DongjuLee0528/wildfire-spot/models/wildfire_baseline/BoxF1_curve.png

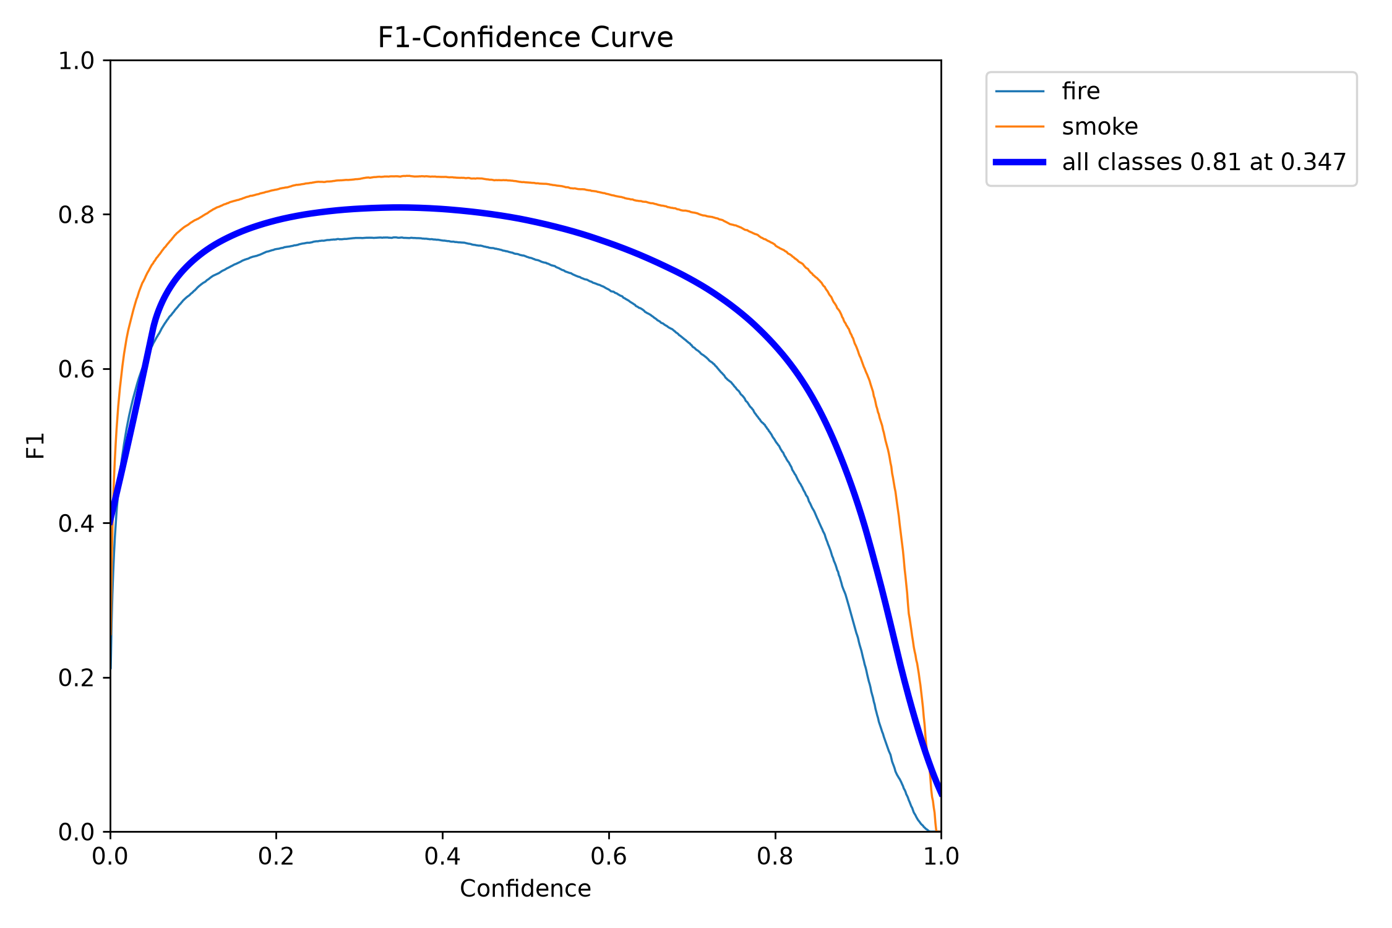
models/wildfire_baseline/BoxF1_curve.png
