DongjuLee0528/wildfire-spot/models/wildfire_baseline/BoxP_curve.png

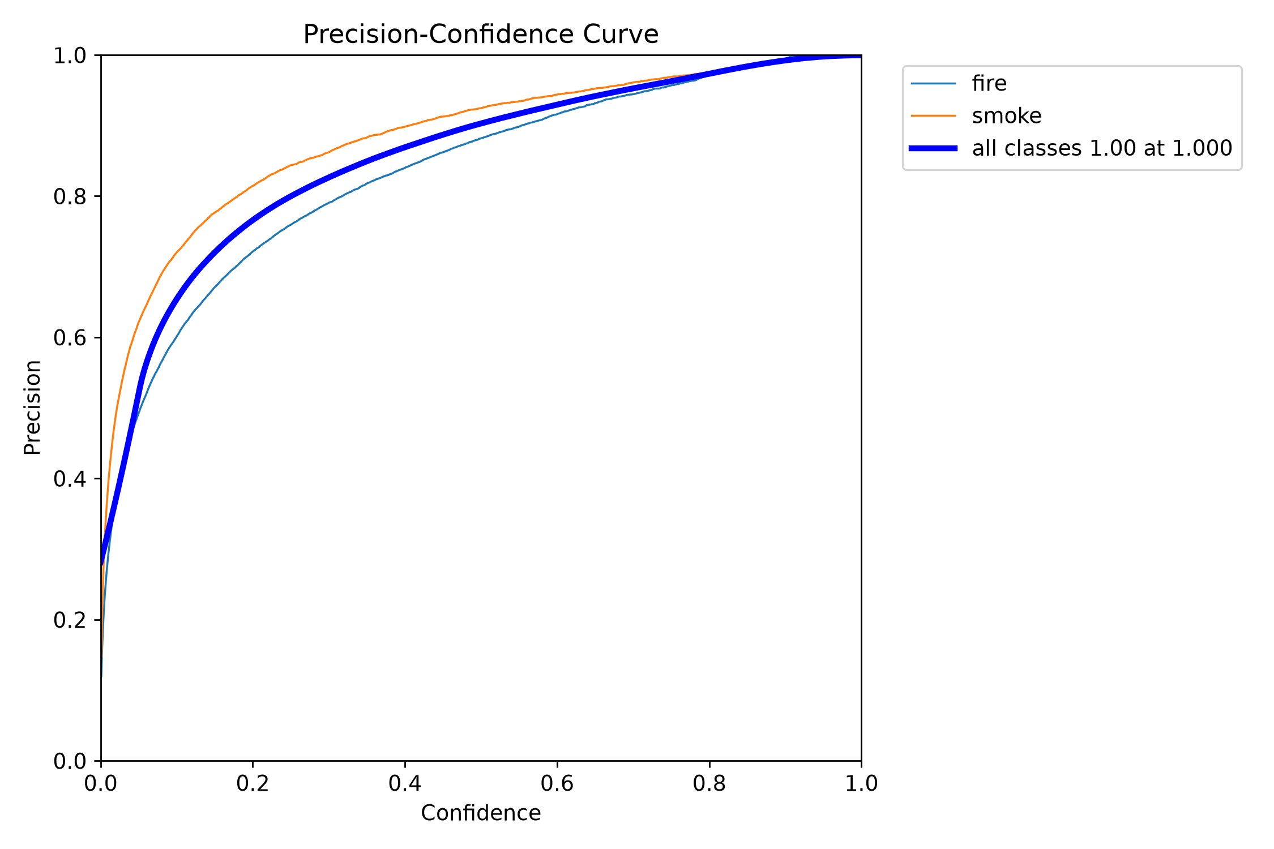
models/wildfire_baseline/BoxP_curve.png
