DongjuLee0528/wildfire-spot/models/wildfire_baseline/BoxPR_curve.png

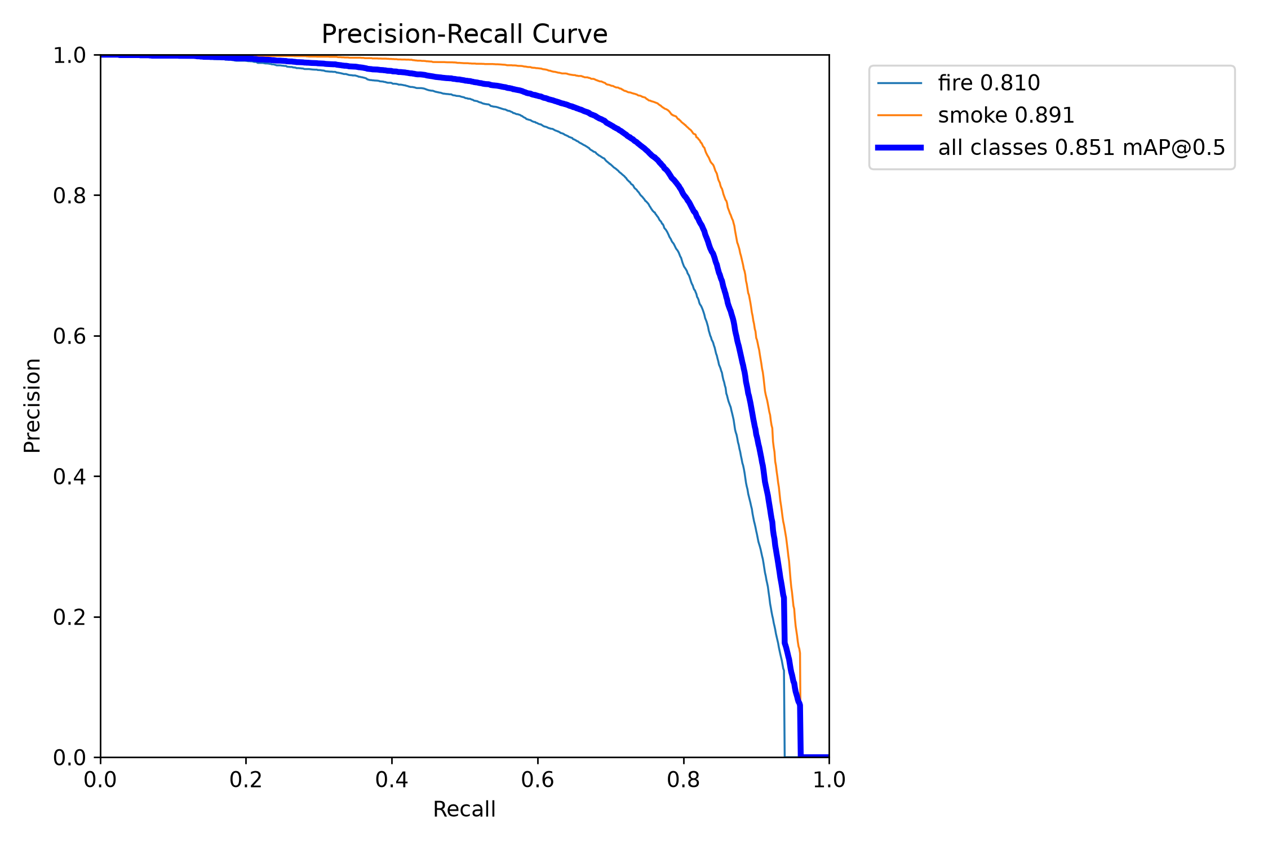
models/wildfire_baseline/BoxPR_curve.png
