DongjuLee0528/wildfire-spot/models/wildfire_baseline/BoxR_curve.png

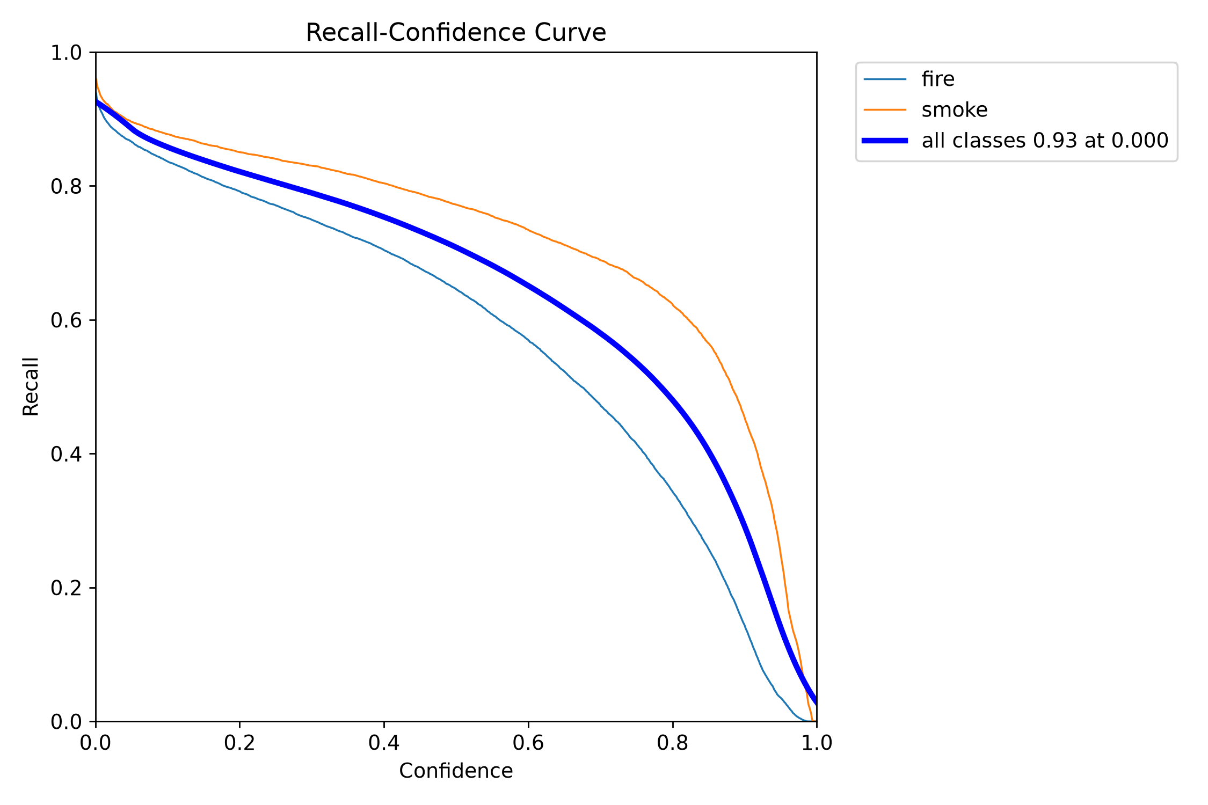
models/wildfire_baseline/BoxR_curve.png
