DongjuLee0528/wildfire-spot/models/wildfire_baseline/confusion_matrix.png

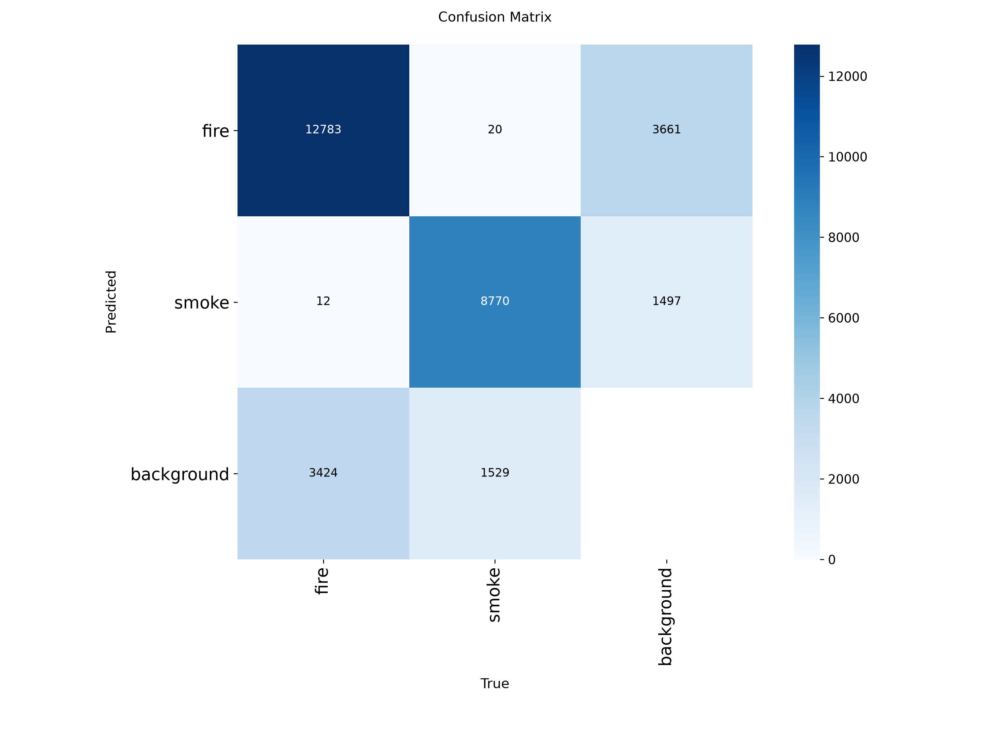
models/wildfire_baseline/confusion_matrix.png
