DongjuLee0528/wildfire-spot/models/wildfire_baseline/confusion_matrix_normalized.png

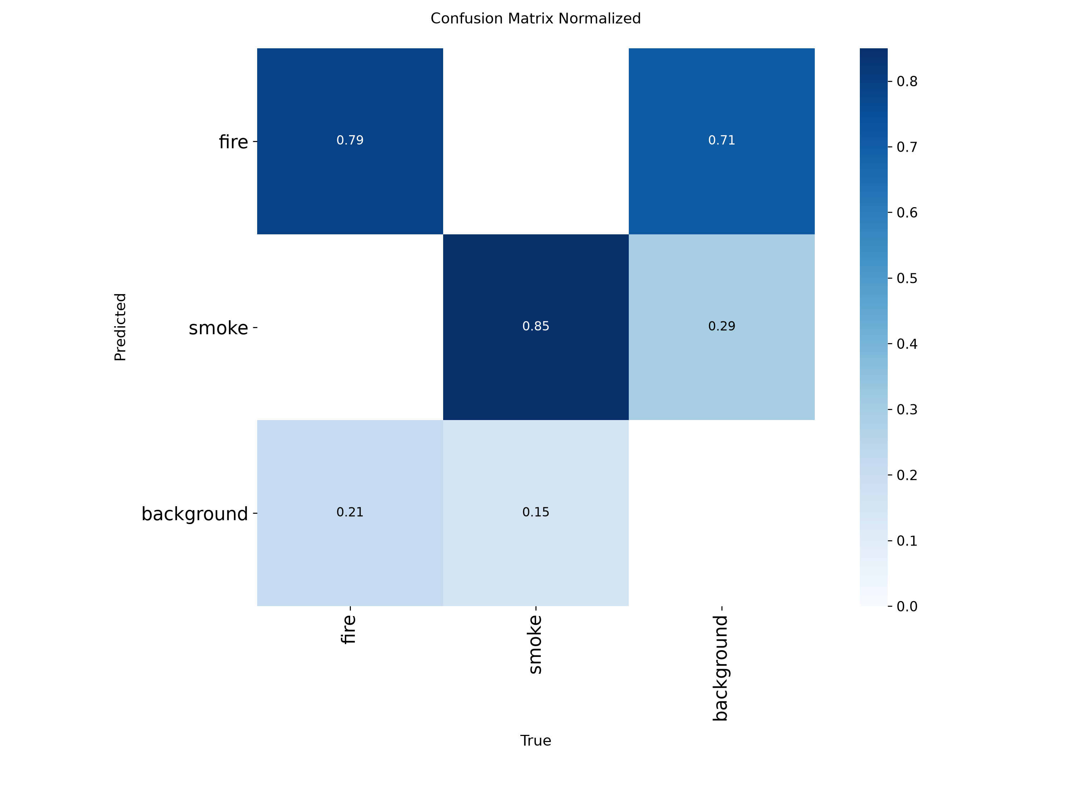
models/wildfire_baseline/confusion_matrix_normalized.png
