DongjuLee0528/wildfire-spot/hardware_cad/stl/R_arm_x2.stl

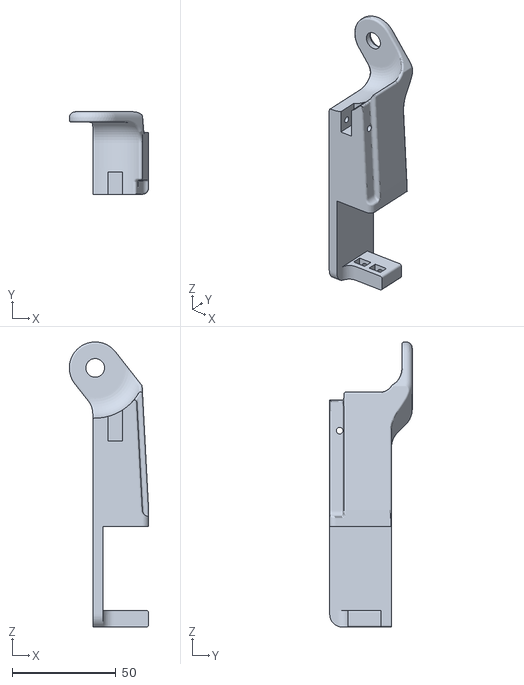
[picture p7: CAD file, 2026-06-15]
hardware_cad/stl/R_arm_x2.stl
38.2 x 39.8 x 137.4
