DongjuLee0528/wildfire-spot/hardware_cad/stltest/lidar_arm.lidar_arm01.stl

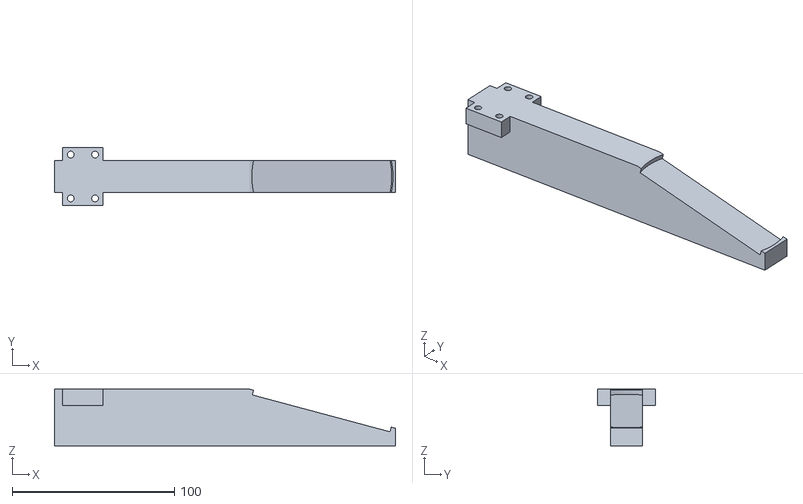
[picture p8: CAD file, 2026-06-16]
hardware_cad/stltest/lidar_arm.lidar_arm01.stl
210.0 x 36.0 x 35.0
