DongjuLee0528/wildfire-spot/hardware_cad/stl/R_wrist_x2.stl

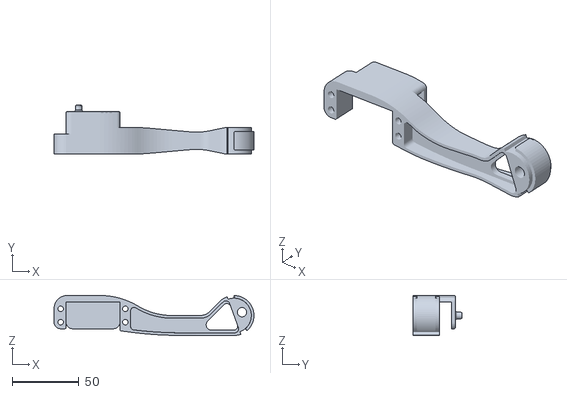
[picture p9: CAD file, 2026-06-15]
hardware_cad/stl/R_wrist_x2.stl
150.0 x 36.9 x 30.0
