DongjuLee0528/wildfire-spot/hardware_cad/stltest/side_cover.stl

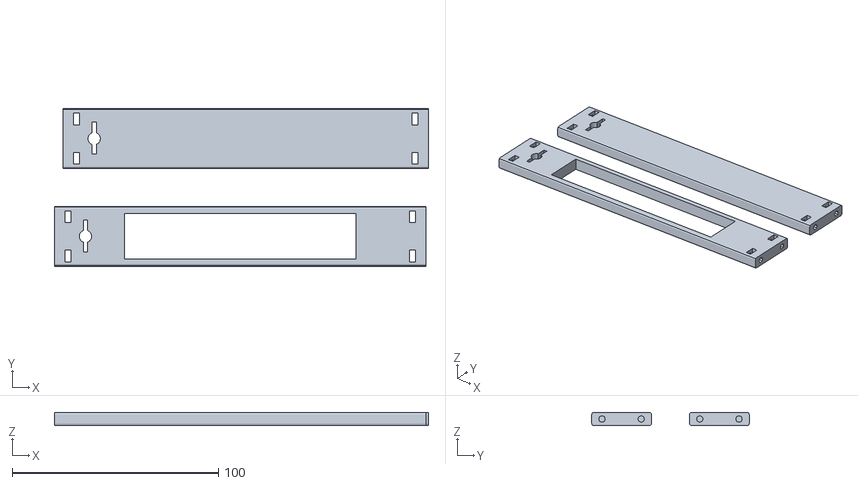
[picture p10: CAD file, 2026-06-16]
hardware_cad/stltest/side_cover.stl
181.2 x 76.4 x 6.50
