DongjuLee0528/wildfire-spot/hardware_cad/stl/R_shoulder.stl

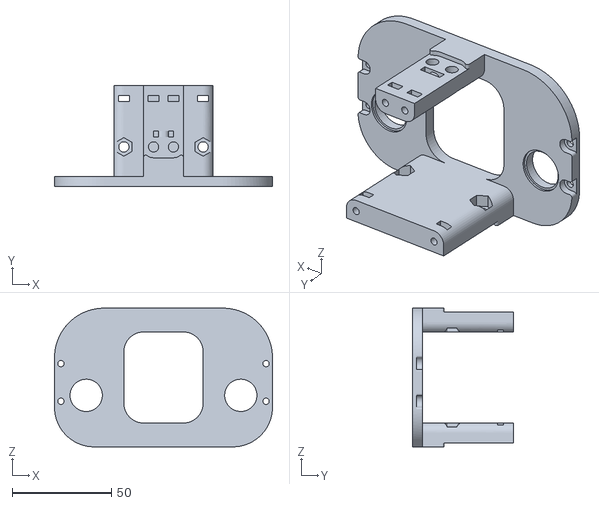
[picture p11: CAD file, 2026-06-15]
hardware_cad/stl/R_shoulder.stl
110.0 x 51.0 x 70.0
