DongjuLee0528/wildfire-spot/hardware_cad/stltest/lidar_arm.lidar_arm02.stl

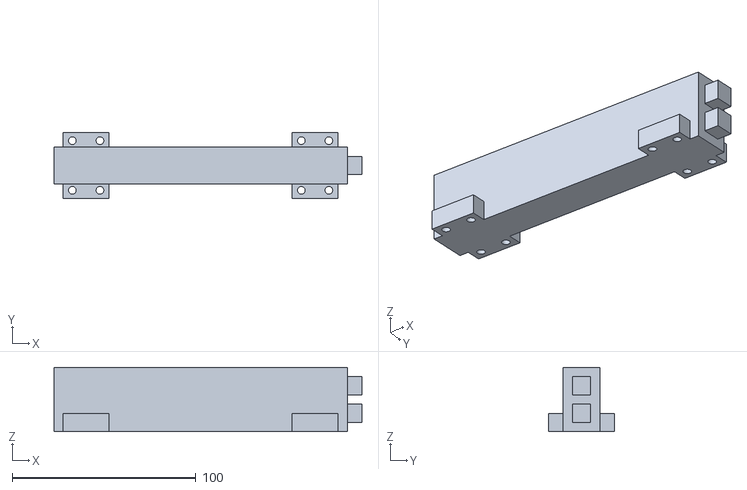
[picture p12: CAD file, 2026-06-16]
hardware_cad/stltest/lidar_arm.lidar_arm02.stl
167.5 x 36.0 x 35.0
