DongjuLee0528/wildfire-spot/hardware_cad/stl/R_side_plate.stl

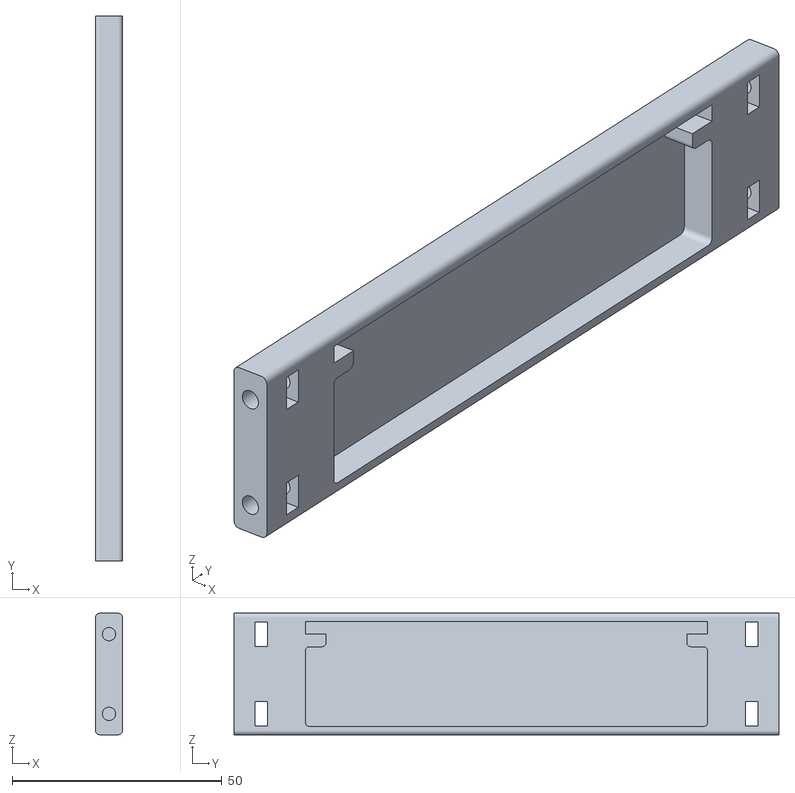
[picture p13: CAD file, 2026-06-15]
hardware_cad/stl/R_side_plate.stl
6.50 x 130.0 x 29.0
