DongjuLee0528/wildfire-spot/hardware_cad/stltest/Front_Cover.stl

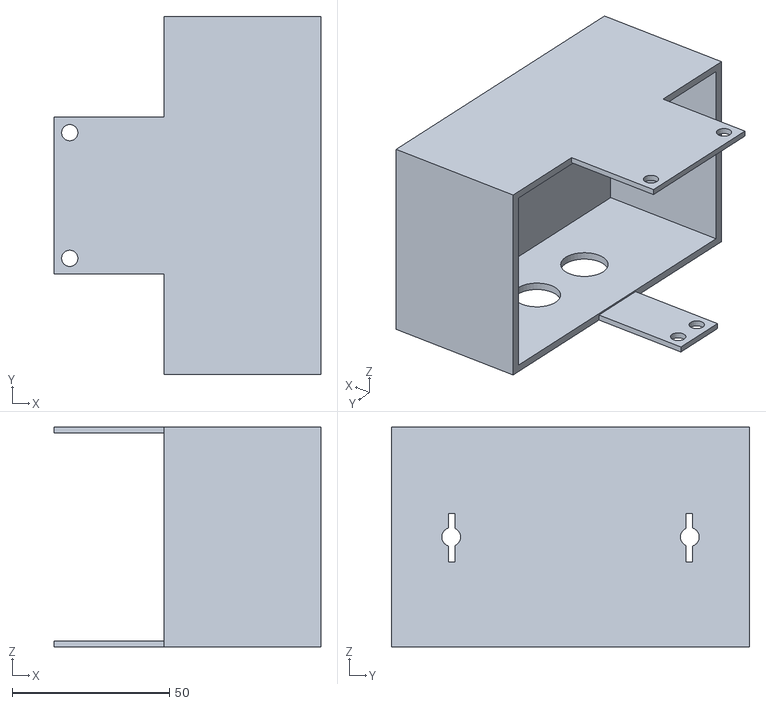
[picture p14: CAD file, 2026-06-16]
hardware_cad/stltest/Front_Cover.stl
85.0 x 114.0 x 70.0
