DongjuLee0528/wildfire-spot/hardware_cad/stl/top_cover.stl

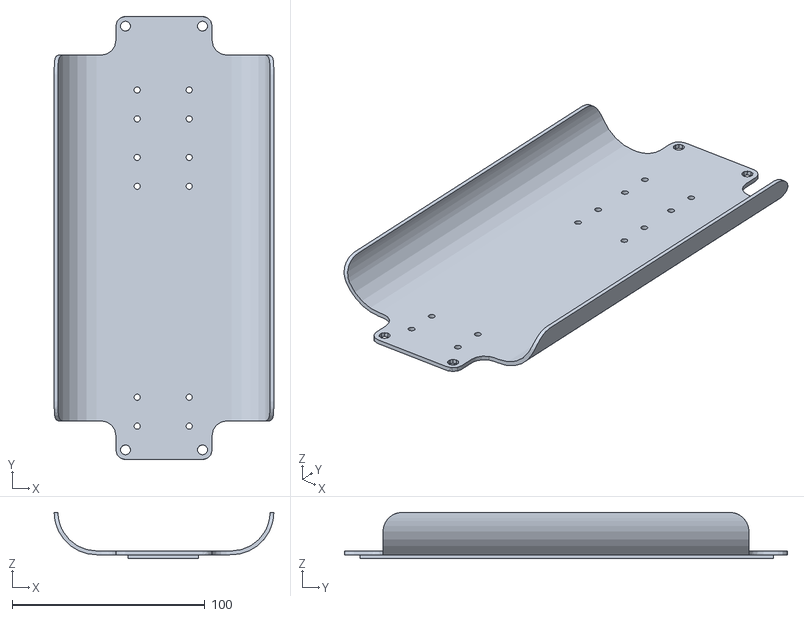
[picture p15: CAD file, 2026-06-15]
hardware_cad/stl/top_cover.stl
114.0 x 230.0 x 24.0
