DongjuLee0528/wildfire-spot/hardware_cad/stl/R_arm_cover_x2.stl

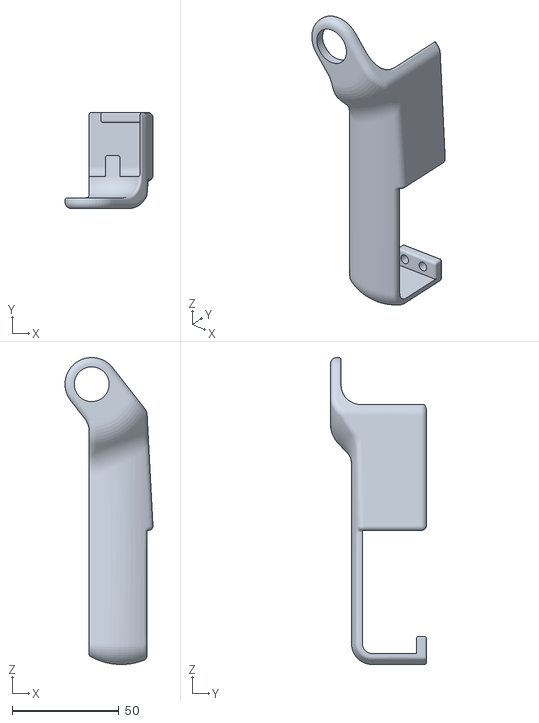
[picture p16: CAD file, 2026-06-14]
hardware_cad/stl/R_arm_cover_x2.stl
41.2 x 45.0 x 143.5
