DongjuLee0528/wildfire-spot/hardware_cad/stl/lidar_plate.lidar_plate.stl

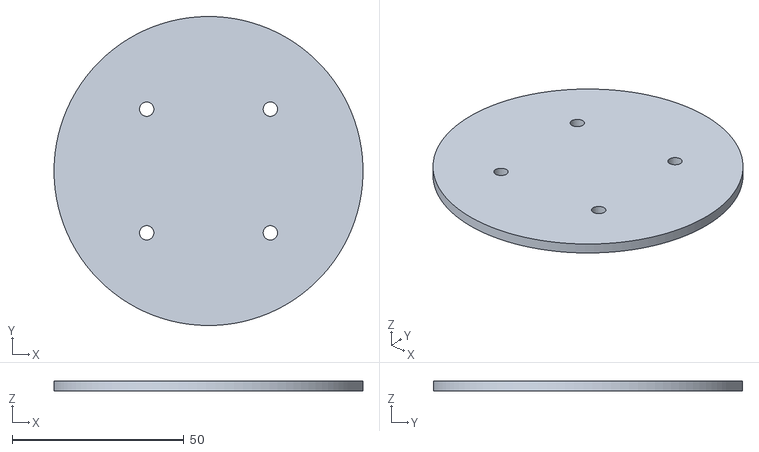
[picture p17: CAD file, 2026-06-14]
hardware_cad/stl/lidar_plate.lidar_plate.stl
90.0 x 90.0 x 3.00
