DongjuLee0528/wildfire-spot/hardware_cad/stl/L_side_plate.stl

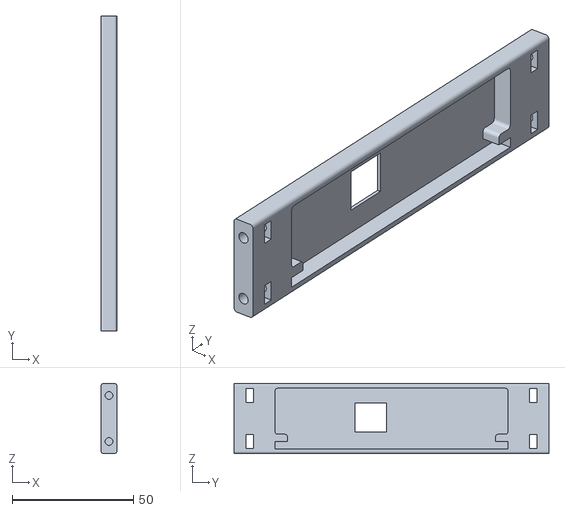
[picture p18: CAD file, 2026-06-14]
hardware_cad/stl/L_side_plate.stl
6.50 x 130.0 x 29.0
