DongjuLee0528/wildfire-spot/hardware_cad/stl/R_arm_joint_x2.stl

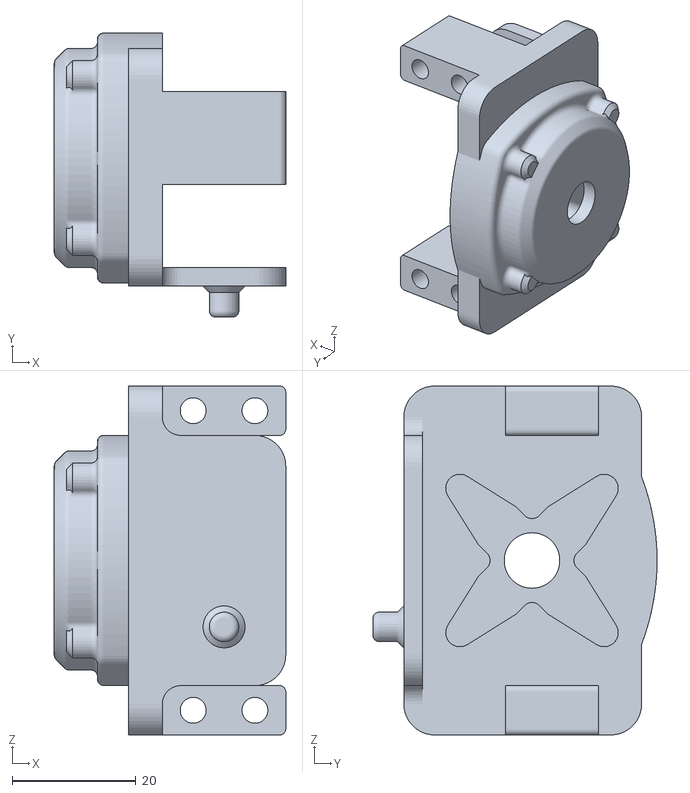
[picture p19: CAD file, 2026-06-14]
hardware_cad/stl/R_arm_joint_x2.stl
37.5 x 46.0 x 56.5
