DongjuLee0528/wildfire-spot/hardware_cad/stl/mg995_servo_holder.stl

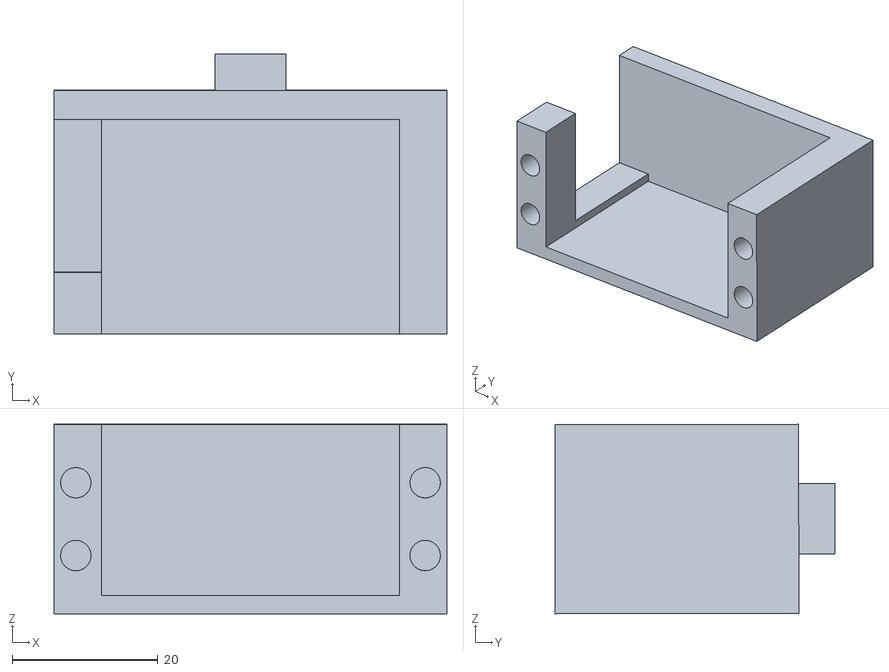
[picture p20: CAD file, 2026-06-14]
hardware_cad/stl/mg995_servo_holder.stl
54.0 x 38.5 x 26.0
