DongjuLee0528/wildfire-spot/hardware_cad/stl/lidar_arm.lidar_arm.stl

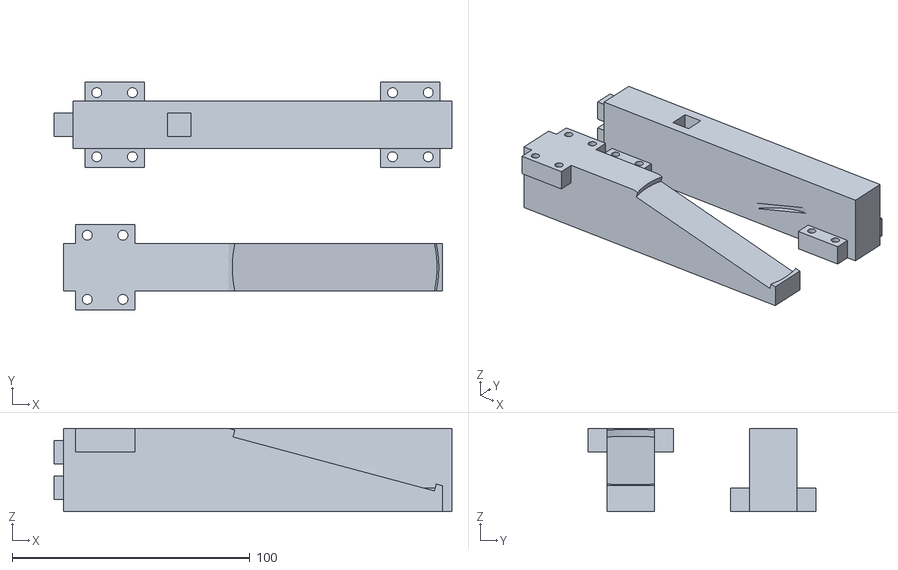
[picture p21: CAD file, 2026-06-14]
hardware_cad/stl/lidar_arm.lidar_arm.stl
167.5 x 96.0 x 35.0
