DongjuLee0528/wildfire-spot/hardware_cad/stl/F_shoulder.stl

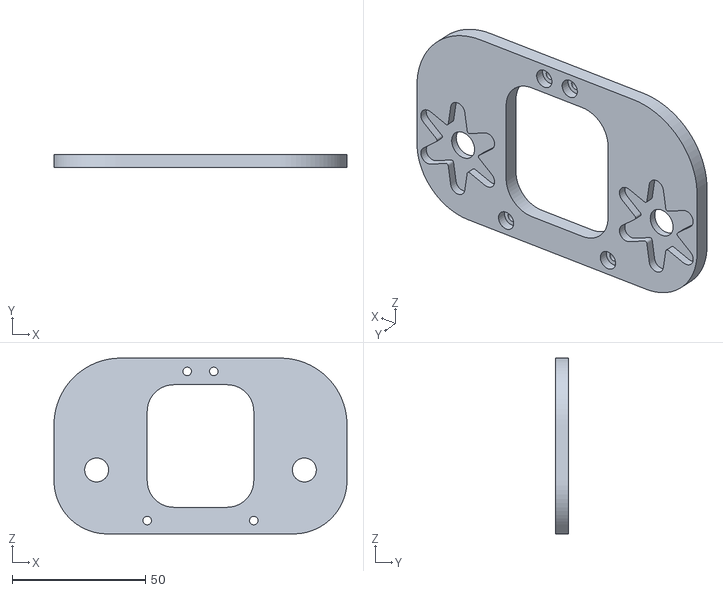
[picture p22: CAD file, 2026-06-13]
hardware_cad/stl/F_shoulder.stl
110.0 x 5.00 x 66.0
