DongjuLee0528/wildfire-spot/hardware_cad/stl/bottom_cover.stl

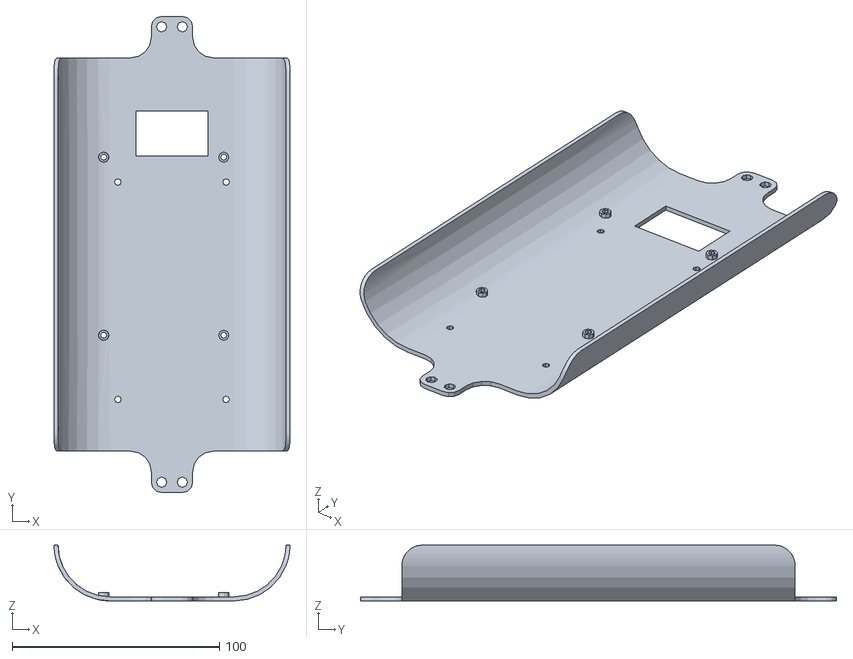
[picture p23: CAD file, 2026-06-13]
hardware_cad/stl/bottom_cover.stl
114.0 x 230.0 x 27.0
