DongjuLee0528/wildfire-spot/hardware_cad/stl/battery_cover.battery_cover.stl

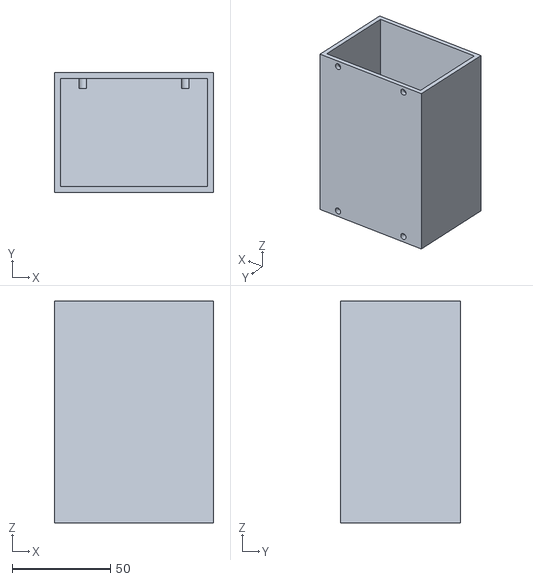
[picture p24: CAD file, 2026-06-13]
hardware_cad/stl/battery_cover.battery_cover.stl
81.0 x 61.0 x 113.0
