DongjuLee0528/wildfire-spot/(list of files, cad)

Other CAD files:
hardware_cad/stl/L_wrist_x2.stl
hardware_cad/stl/L_arm_cover_x2.stl
hardware_cad/stl/L_arm_joint_x2.stl
hardware_cad/stl/L_arm_x2.stl
