DongjuLee0528/wildfire-spot/models/wildfire_baseline/results.csv

epoch | time | train/box_loss | train/cls_loss | train/dfl_loss | metrics/precision(B) | metrics/recall(B) | metrics/mAP50(B) | metrics/mAP50-95(B) | val/box_loss | val/cls_loss | val/dfl_loss | lr/pg0 | lr/pg1 | lr/pg2 | lr/pg3 | lr/pg4 | lr/pg5 | lr/pg6 | lr/pg7
1 | 4322.97 | 1.55921 | 2.16494 | 1.56906 | 0.68608 | 0.61561 | 0.67741 | 0.35 | 1.6771 | 1.45263 | 1.60846 | 0.0099988 | 0.00333293 | 0.0099988 | 0.00333293 | 0.0099988 | 0.00333293 | 0.0099988 | 0.00333293
2 | 9353.63 | 1.54447 | 1.658 | 1.56434 | 0.7005 | 0.63101 | 0.69673 | 0.37994 | 1.57246 | 1.4124 | 1.55244 | 0.0198998 | 0.00663327 | 0.0198998 | 0.00663327 | 0.0198998 | 0.00663327 | 0.0198998 | 0.00663327
3 | 12533.6 | 1.54933 | 1.64297 | 1.57384 | 0.70442 | 0.63061 | 0.70209 | 0.39707 | 1.52544 | 1.3829 | 1.53039 | 0.0297018 | 0.0099006 | 0.0297018 | 0.0099006 | 0.0297018 | 0.0099006 | 0.0297018 | 0.0099006
4 | 15646 | 1.51858 | 1.55495 | 1.55165 | 0.73068 | 0.64287 | 0.72441 | 0.41471 | 1.49531 | 1.3273 | 1.50934 | 0.0295545 | 0.0098515 | 0.0295545 | 0.0098515 | 0.0295545 | 0.0098515 | 0.0295545 | 0.0098515
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
