DongjuLee0528/wildfire-spot/models/wildfire_baseline/results.png

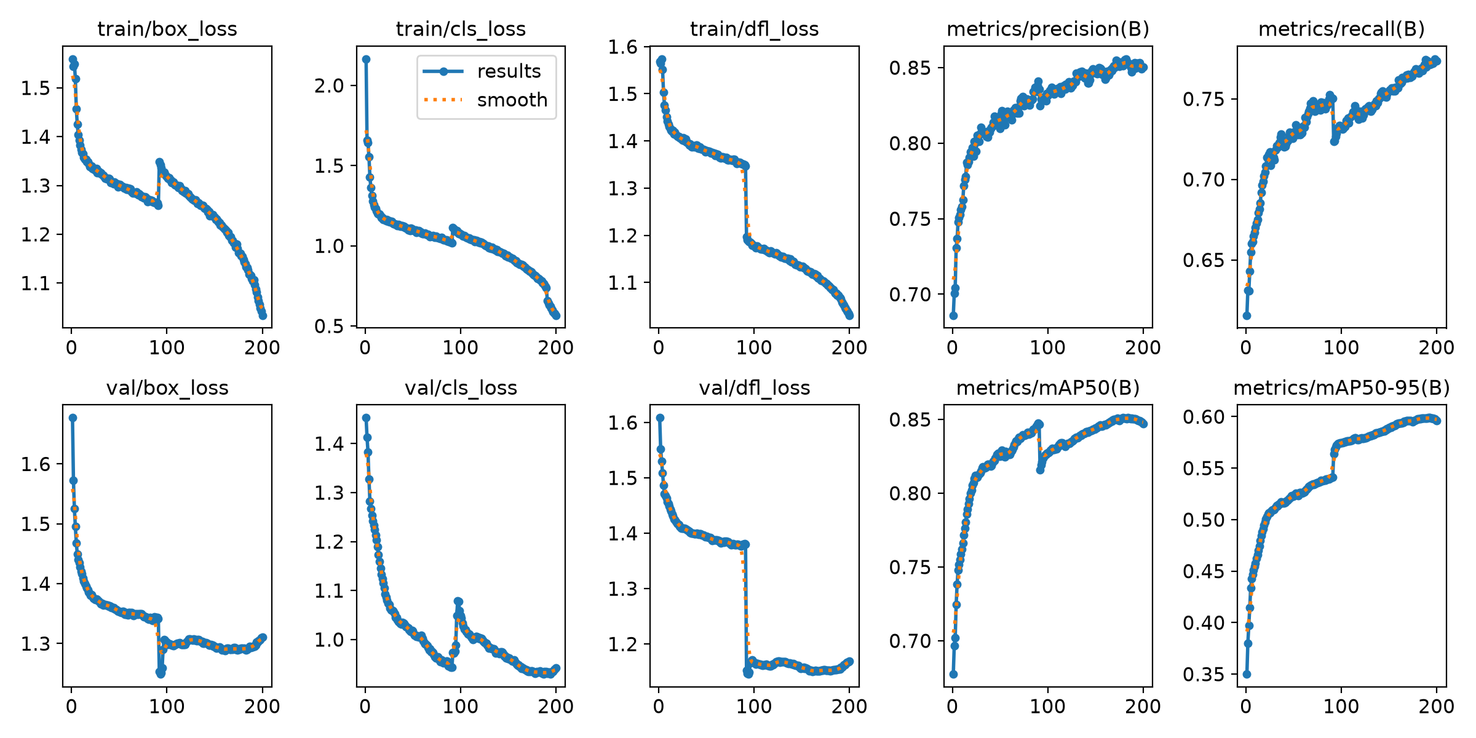
models/wildfire_baseline/results.png
