DongjuLee0528/wildfire-spot/hardware/sensor_manager.py

"""
Sensor management module for wildfire detection.

Integrates multiple sensor types:
- DHT11 temperature and humidity sensor
- KY-026 flame detection sensors
- HC-SR04 ultrasonic distance sensor
"""

from utils.config import (I2C_SCL, I2C_SDA, DHT11_DATA_PIN,
                         KY026_FRONT_LEFT_PIN, KY026_FRONT_RIGHT_PIN, KY026_LEFT_PIN, KY026_RIGHT_PIN,
                         HCSR04_TRIGGER_PIN, HCSR04_ECHO_PIN, ULTRASONIC_DISTANCE_MULTIPLIER,
                         SENSOR_READ_TIMEOUT)
from utils.logger import WildfireLogger

import time

try:
    import adafruit_dht
except ImportError:
    adafruit_dht = None

try:
    import board
except ImportError:
    board = None

try:
    import Jetson.GPIO as GPIO
except ImportError:
    GPIO = None

try:
    import busio
except ImportError:
    busio = None

class FlameReadings(dict):
    """
    Dict subclass for KY-026 flame sensor readings.

    Keyed by position string ('front_left', 'front_right', 'left', 'right').
    Iterating yields values (not keys) so it behaves like a list of booleans
    when consumed by FireDetector._flame_values().
    Integer indexing by position is also supported for legacy callers.
    """

    def __iter__(self):
        """Iterate over values (True/False/None per sensor) instead of keys."""
        return iter(self.values())

    def __bool__(self):
        """Return True if any sensor reports flame detected."""
        return any(self.values())

    def __getitem__(self, key):
        """Support both string key ('front_left') and integer index (0-3)."""
        if isinstance(key, int):
            return list(self.values())[key]
        return super().__getitem__(key)


class SensorManager:
    """
    Manages all environmental sensors for fire detection.

    Handles initialization, reading, and error recovery for:
    - Temperature/humidity monitoring (DHT11)
    - Flame detection (KY-026 IR sensors)
    - Obstacle distance measurement (HC-SR04)
    """
    def __init__(self):
        """
        Initialize all sensors with graceful degradation.

        If individual sensors fail to initialize, the system continues
        operation with available sensors. Failures are logged for debugging.
        """
        self._i2c = None
        self._dht11_available = False
        self._gpio_available = False
        self._last_dht11_reading = None
        self.logger = WildfireLogger("SensorManager")

        if busio is None:
            self.logger.log_error("SensorManager.I2C_init", "busio module is not available")
        else:
            try:
                self._i2c = busio.I2C(I2C_SCL, I2C_SDA)
            except (ValueError, RuntimeError, OSError) as e:
                self.logger.log_error("SensorManager.I2C_init", str(e))

        if adafruit_dht is None:
            self.logger.log_error("SensorManager.DHT11_init", "adafruit_dht module is not available")
        elif board is None:
            self.logger.log_error("SensorManager.DHT11_init", "board module is not available")
        else:
            try:
                self._dht11 = adafruit_dht.DHT11(self._get_dht11_board_pin(DHT11_DATA_PIN))
                self._dht11_available = True
            except (ValueError, RuntimeError, OSError, AttributeError) as e:
                self.logger.log_error("SensorManager.DHT11_init", str(e))

        if GPIO is None:
            self.logger.log_error("SensorManager.GPIO_setmode", "Jetson.GPIO module is not available")
        else:
            try:
                GPIO.setmode(GPIO.BOARD)
                self._gpio_available = True
            except (ValueError, RuntimeError, AttributeError) as e:
                self.logger.log_error("SensorManager.GPIO_setmode", str(e))

        self._ky026_pins = {
            "front_left": KY026_FRONT_LEFT_PIN,
            "front_right": KY026_FRONT_RIGHT_PIN,
            "left": KY026_LEFT_PIN,
            "right": KY026_RIGHT_PIN,
        }
        for pin in self._ky026_pins.values():
            if self._gpio_available and pin is not None:
                try:
                    GPIO.setup(pin, GPIO.IN)
                except (ValueError, RuntimeError, AttributeError) as e:
                    self.logger.log_error("SensorManager.GPIO_setup_KY026", str(e))

        if self._gpio_available and HCSR04_TRIGGER_PIN is not None and HCSR04_ECHO_PIN is not None:
            try:
                GPIO.setup(HCSR04_TRIGGER_PIN, GPIO.OUT)
                GPIO.setup(HCSR04_ECHO_PIN, GPIO.IN)
            except (ValueError, RuntimeError, AttributeError) as e:
                self.logger.log_error("SensorManager.GPIO_setup_HCSR04", str(e))

    def _get_dht11_board_pin(self, pin):
        """
        Translate a BOARD pin number into the corresponding adafruit board attribute.

        Args:
            pin: Integer BOARD pin number (e.g. 18).

        Returns:
            board.Dxx attribute object for use with adafruit_dht.

        Raises:
            ValueError: if the pin number is not in the supported mapping.
            AttributeError: if the board module lacks the expected attribute.
        """
        supported_pins = {
            18: "D18",
        }
        pin_name = supported_pins.get(pin)
        if pin_name is None:
            raise ValueError(f"Unsupported DHT11 BOARD pin: {pin}")
        try:
            return getattr(board, pin_name)
        except AttributeError as e:
            raise AttributeError(f"board.{pin_name} is not available") from e

    def read_dht11(self):
        """
        Read temperature and humidity from DHT11 sensor.

        Retries up to 3 times with 1-second delays because DHT11 frequently
        returns checksum errors on the first read after a period of inactivity.
        Falls back to the last successful reading (_last_dht11_reading) so
        callers always receive a value even during transient sensor errors.

        Returns:
            Tuple of (temperature in Celsius, relative humidity percentage)
            Returns the previous valid reading or None if unavailable or all reads fail
        """
        if not self._dht11_available or not hasattr(self, '_dht11'):
            return self._last_dht11_reading

        last_error = None
        for attempt in range(3):
            try:
                temperature = self._dht11.temperature
                humidity = self._dht11.humidity
                if temperature is not None and humidity is not None:
                    self._last_dht11_reading = (temperature, humidity)
                    return self._last_dht11_reading
            except (ValueError, RuntimeError, OSError, AttributeError) as e:
                last_error = e

            if attempt < 2:
                time.sleep(1.0)

        self.logger.warning(f"SensorManager.read_dht11 failed after retries: {last_error}")
        return self._last_dht11_reading

    def read_ky026(self):
        """
        Read flame detection from KY-026 IR sensors.

        Returns:
            Mapping of 4 boolean values indicating flame detection for each sensor
            True means flame detected in that direction
            Returns None if GPIO is unavailable
            Note: KY-026 outputs LOW when flame detected, so we invert the reading
        """
        flame_detected = FlameReadings()
        if not self._gpio_available:
            return None

        for position, pin in self._ky026_pins.items():
            if pin is not None:
                try:
                    flame_detected[position] = not GPIO.input(pin)
                except (ValueError, RuntimeError, AttributeError) as e:
                    self.logger.log_error("SensorManager.read_ky026", str(e))
                    flame_detected[position] = None
            else:
                flame_detected[position] = None
        return flame_detected

    def read_hcsr04(self):
        """
        Read distance from HC-SR04 ultrasonic sensor.

        Returns:
            Distance in centimeters (rounded to 2 decimal places)
            Returns None if sensor unavailable, timeout, or read fails
        """
        if not self._gpio_available or HCSR04_TRIGGER_PIN is None or HCSR04_ECHO_PIN is None:
            return None

        try:
            GPIO.output(HCSR04_TRIGGER_PIN, GPIO.LOW)
            time.sleep(0.000002)
            GPIO.output(HCSR04_TRIGGER_PIN, GPIO.HIGH)
            time.sleep(0.00001)
            GPIO.output(HCSR04_TRIGGER_PIN, GPIO.LOW)

            timeout_start = time.time()
            pulse_start = time.time()
            while GPIO.input(HCSR04_ECHO_PIN) == 0:
                pulse_start = time.time()
                if time.time() - timeout_start > SENSOR_READ_TIMEOUT:
                    return None
                time.sleep(0.0001)

            timeout_start = time.time()
            pulse_end = time.time()
            while GPIO.input(HCSR04_ECHO_PIN) == 1:
                pulse_end = time.time()
                if time.time() - timeout_start > SENSOR_READ_TIMEOUT:
                    return None
                time.sleep(0.0001)

            pulse_duration = pulse_end - pulse_start
            distance = pulse_duration * ULTRASONIC_DISTANCE_MULTIPLIER

            return round(distance, 2)
        except (ValueError, RuntimeError, AttributeError) as e:
            self.logger.log_error("SensorManager.read_hcsr04", str(e))
            return None

    def read_all(self):
        """
        Read all sensors and return raw consolidated data.

        Returns:
            Dictionary containing all sensor readings:
            - temperature: Temperature in Celsius, or None when unavailable
            - humidity: Relative humidity percentage, or None when unavailable
            - flame: FlameReadings dict keyed by position, or None when unavailable
            - flame_list: list of flame values in position order, or None when unavailable
            - distance: Ultrasonic distance in cm, or None when unavailable
        """
        dht = self.read_dht11()
        temperature, humidity = dht if dht is not None else (None, None)
        flame = self.read_ky026()
        distance = self.read_hcsr04()

        sensor_data = {
            "temperature": temperature,
            "humidity": humidity,
            "flame": flame,
            "flame_list": list(flame.values()) if flame is not None else None,
            "distance": distance
        }

        self.logger.log_sensor_values(sensor_data)
        return sensor_data

    def is_dht11_available(self) -> bool:
        """Return True if the DHT11 temperature/humidity sensor path is available."""
        return self._dht11_available

    def is_gpio_available(self) -> bool:
        """Return True if the GPIO / KY-026 flame sensor path is available."""
        return self._gpio_available

    def is_available(self) -> bool:
        """Return True if at least one sensor path is available."""
        return self._dht11_available or self._gpio_available

    def cleanup(self):
        """
        Release hardware resources.

        Deinitializes I2C bus and cleans up GPIO pins.
        Should be called during system shutdown.
        """
        try:
            if self._i2c is not None:
                self._i2c.deinit()
        except (ValueError, RuntimeError, AttributeError) as e:
            self.logger.log_error("SensorManager.cleanup_i2c", str(e))

        try:
            if self._gpio_available:
                GPIO.cleanup()
        except (ValueError, RuntimeError, AttributeError) as e:
            self.logger.log_error("SensorManager.cleanup_gpio", str(e))
