DongjuLee0528/wildfire-spot/robot/robot_api_server.py

"""
DEPRECATED: This module has been removed.

robot.robot_api is the single source of truth for the Python Robot API.

Run with:
    uvicorn robot.robot_api:app --host 0.0.0.0 --port 8000
"""

raise ImportError(
    "robot.robot_api_server is deprecated and has been removed. "
    "Use robot.robot_api instead."
)
