DongjuLee0528/wildfire-spot/utils/config.py

"""Central configuration for the Wildfire Spot robot.

All hardware addresses, pin assignments, thresholds, gait parameters,
and training settings are defined here. Values can be overridden via
environment variables where noted.
"""

import math
import os
from pathlib import Path


def _env_path(name, default):
    """Return a resolved filesystem path from an env variable, falling back to default."""
    return str(Path(os.environ.get(name, default)).expanduser())


def _env_int(name, default):
    """Return an integer from an env variable, falling back to default on missing or invalid value."""
    value = os.environ.get(name)
    if value is None or value.strip() == "":
        return default
    try:
        return int(value)
    except ValueError:
        print(f"Invalid integer for {name}: {value}. Using default: {default}")
        return default


def _env_int_or_auto(name, default):
    """Return an integer or the string 'auto' from an env variable, falling back to default."""
    value = os.environ.get(name)
    if value is None or value.strip() == "":
        return default
    if value.strip().lower() == "auto":
        return "auto"
    try:
        return int(value)
    except ValueError:
        print(f"Invalid integer for {name}: {value}. Using default: {default}")
        return default


def _env_float(name, default):
    """Return a float from an env variable, falling back to default on missing or invalid value."""
    value = os.environ.get(name)
    if value is None or value.strip() == "":
        return default
    try:
        return float(value)
    except ValueError:
        print(f"Invalid float for {name}: {value}. Using default: {default}")
        return default


def _bounded_float(name, default, min_value, max_value):
    value = _env_float(name, default)
    if not math.isfinite(value):
        print(f"Invalid finite float for {name}: {value}. Using default: {default}")
        value = default
    return min(max(value, min_value), max_value)


def _bounded_int(name, default, min_value, max_value):
    return min(max(_env_int(name, default), min_value), max_value)


def _env_bool(name, default=False):
    """Return a boolean from an env variable; truthy strings are '1', 'true', 'yes', 'on'."""
    value = os.environ.get(name)
    if value is None:
        return default
    return value.strip().lower() in {"1", "true", "yes", "on"}


def _env_int_or_none(name, default):
    """Return an int (hex or decimal), None, or default from an env variable.

    Accepts: hex string ("0x48"), decimal string ("72"), empty string or
    case-insensitive "none" (both become None). Invalid values fall back to
    default with a warning print.
    """
    value = os.environ.get(name)
    if value is None:
        return default
    stripped = value.strip()
    if stripped == "" or stripped.lower() == "none":
        return None
    try:
        return int(stripped, 0)
    except ValueError:
        print(f"Invalid int/hex for {name}: {value!r}. Using default: {default}")
        return default

try:
    import board
    I2C_SCL = board.SCL_1
    I2C_SDA = board.SDA_1
except (ImportError, AttributeError):
    I2C_SCL = None
    I2C_SDA = None

BASE_DIR = _env_path("WILDFIRE_BASE_DIR", "/workspace")
LOG_DIR = _env_path("WILDFIRE_LOG_DIR", os.path.join(BASE_DIR, "wildfire_logs"))
GAIT_DIAGNOSTIC_LOG_ENABLED = _env_bool("GAIT_DIAGNOSTIC_LOG_ENABLED", False)
GAIT_DIAGNOSTIC_LOG_PATH = _env_path("GAIT_DIAGNOSTIC_LOG_PATH", os.path.join(LOG_DIR, "gait_diagnostics.jsonl"))
GAIT_DIAGNOSTIC_LOG_RATE_HZ = _bounded_float("GAIT_DIAGNOSTIC_LOG_RATE_HZ", 5.0, 0.1, 20.0)
GAIT_DIAGNOSTIC_LOG_MAX_BYTES = _bounded_int("GAIT_DIAGNOSTIC_LOG_MAX_BYTES", 5 * 1024 * 1024, 1024, 100 * 1024 * 1024)
GAIT_DIAGNOSTIC_LOG_BACKUPS = _bounded_int("GAIT_DIAGNOSTIC_LOG_BACKUPS", 2, 0, 10)
GAIT_DIAGNOSTIC_REACH_WARNING_RATIO = _bounded_float("GAIT_DIAGNOSTIC_REACH_WARNING_RATIO", 0.95, 0.0, 1.0)

PCA9685_FRONT_LEGS = 0x41
PCA9685_BACK_LEGS = 0x42

MPU6050_ADDRESS = 0x68

PWM_FREQUENCY = 60
PWM_MIN_PULSE = 460
PWM_MAX_PULSE = 2440
SERVO_ANGLE_MIN = 0
SERVO_ANGLE_MAX = 180

FL_LOWER = 0
FL_UPPER = 1
FL_SHOULDER = 2

FR_LOWER = 3
FR_UPPER = 4
FR_SHOULDER = 5

BL_LOWER = 6
BL_UPPER = 7
BL_SHOULDER = 8

BR_LOWER = 9
BR_UPPER = 10
BR_SHOULDER = 11

CAMERA_PAN_CHANNEL = 6
CAMERA_TILT_CHANNEL = 7
CAMERA_PAN_STOP_THROTTLE = 0.0
CAMERA_PAN_LEFT_THROTTLE = -0.5
CAMERA_PAN_RIGHT_THROTTLE = 0.5
CAMERA_TILT_INITIAL_ANGLE = 90
CAMERA_TILT_MIN_ANGLE = 0
CAMERA_TILT_MAX_ANGLE = 180
CAMERA_TILT_STEP_ANGLE = 10

SERVO_OFFSETS = [180, 90, 90, 1, 90, 90, 180, 90, 90, 1, 90, 90]  # Per-channel angle offsets that correct for physical servo mounting orientation

GPS_UART_PORT = os.environ.get("WILDFIRE_GPS_UART_PORT", "/dev/ttyTHS1")
GPS_BAUDRATE = _env_int("WILDFIRE_GPS_BAUDRATE", 9600)

LIDAR_TRANSPORT = "ethernet"
L2_POINT_CLOUD_ENABLED = _env_bool("L2_POINT_CLOUD_ENABLED", True)
L2_RECEIVER_PATH = _env_path("L2_RECEIVER_PATH", "~/workspace/wildfire-l2-build/l2_receiver")

LIDAR_ETHERNET_LIDAR_IP = os.environ.get("WILDFIRE_LIDAR_IP", "192.168.1.62")
LIDAR_ETHERNET_HOST_IP = os.environ.get("WILDFIRE_LIDAR_HOST_IP", "192.168.1.2")
LIDAR_ETHERNET_GATEWAY = os.environ.get("WILDFIRE_LIDAR_GATEWAY", "192.168.1.1")
LIDAR_ETHERNET_SUBNET = "255.255.255.0"

LIDAR_ETHERNET_TX_PORT = 6101
LIDAR_ETHERNET_RX_PORT = 6201
LIDAR_SOCKET_TIMEOUT = 1.0

KY026_FRONT_LEFT_PIN = 11
KY026_FRONT_RIGHT_PIN = 13
KY026_LEFT_PIN = 15
KY026_RIGHT_PIN = 16
KY026_PIN_1 = KY026_FRONT_LEFT_PIN
KY026_PIN_2 = KY026_FRONT_RIGHT_PIN
KY026_PIN_3 = KY026_LEFT_PIN
KY026_PIN_4 = KY026_RIGHT_PIN
KY026_COUNT = 4

FLAME_SENSOR_FRONT_LEFT_PIN = _env_int("WILDFIRE_FLAME_FRONT_LEFT_PIN", KY026_FRONT_LEFT_PIN)
FLAME_SENSOR_FRONT_RIGHT_PIN = _env_int("WILDFIRE_FLAME_FRONT_RIGHT_PIN", KY026_FRONT_RIGHT_PIN)
FLAME_SENSOR_LEFT_PIN = _env_int("WILDFIRE_FLAME_LEFT_PIN", KY026_LEFT_PIN)
FLAME_SENSOR_RIGHT_PIN = _env_int("WILDFIRE_FLAME_RIGHT_PIN", KY026_RIGHT_PIN)

DHT11_DATA_PIN = _env_int("WILDFIRE_DHT11_DATA_PIN", 18)
HCSR04_TRIGGER_PIN = None
HCSR04_ECHO_PIN = None

CAMERA_DEVICE = os.environ.get("WILDFIRE_CAMERA_DEVICE", "/dev/video0")
CAMERA_WIDTH = 640
CAMERA_HEIGHT = 480
CAMERA_FPS = 30
CAMERA_CONFIDENCE_THRESHOLD = _env_float("WILDFIRE_CAMERA_CONFIDENCE", 0.50)
CAMERA_IOU_THRESHOLD = _env_float("WILDFIRE_CAMERA_IOU", 0.45)
CAMERA_FIRE_CLASSES = ["fire", "smoke"]

MODEL_PATH = _env_path("WILDFIRE_MODEL_PATH", "models/wildfire_baseline/weights/best.pt")
PERSON_DETECTION_ENABLED = _env_bool("PERSON_DETECTION_ENABLED", False)
PERSON_MODEL_PATH = _env_path("PERSON_MODEL_PATH", str(Path(__file__).resolve().parents[1] / "models/person/yolo11n.pt"))
PERSON_DETECTION_FPS = _bounded_float("PERSON_DETECTION_FPS", 10.0, 0.1, 10.0)
PERSON_CONFIDENCE_THRESHOLD = _bounded_float("PERSON_CONFIDENCE_THRESHOLD", 0.5, 0.01, 1.0)

TEMP_THRESHOLD = 60
HUMIDITY_THRESHOLD = 20

STEP_HEIGHT = 10
FORWARD_DISTANCE = 120
BACKWARD_DISTANCE = -20

SERVO_CHANNELS = 12
FRONT_LEG_CHANNELS = 6

CAMERA_CENTER_ANGLE = 90.0
CAMERA_SCAN_ANGLES = [45.0, 135.0]
TIME_SLEEP_SCAN = [2, 1]

LIDAR_OBSTACLE_THRESHOLD = 500  # Distance in mm below which a scan point is treated as an obstacle
LIDAR_FULL_SCAN_SIZE = 360
LIDAR_DIRECTION_COUNT = 8
LIDAR_DIRECTION_ANGLES = [0, 45, 90, 135, 180, 225, 270, 315]  # Cardinal and intercardinal headings in degrees
LIDAR_ANGLE_RANGE = 22  # Half-width in degrees around each heading used to aggregate scan points
LIDAR_REVERSE_DIRECTION = 180  # Angle added to compute the opposite travel heading
LIDAR_PATH_CHECK_RANGE = 10  # Degrees on each side of a heading checked for a clear path

GAIT_STEP_GAIN = 0.8  # Scaling factor applied to the computed step length
GAIT_MAX_SL = 2  # Maximum step length multiplier
GAIT_BODY_POS = (50.0, 80.0, 0.0)  # Default body position (x, y, z) in mm
GAIT_BODY_ROT = (0, 0, 0)  # Default body rotation (roll, pitch, yaw) in degrees
GAIT_TIMING = [300, 1200, 300, 200]  # Gait phase durations in ms: [lift, swing, lower, stance]
GAIT_INITIAL_VALUES = [0.0, 0, 0]
GAIT_FOOT_POSITIONS = [87, 77]  # Default foot x/z rest positions in mm
GAIT_RC = [-50, 0, 0, 1]
GAIT_ANGLE_STEP = 0.5  # Step size in degrees for iterative IK angle search
GAIT_END_Y = 0
GAIT_TOTAL_TIME_CALC = 1000  # Multiplier converting gait time from seconds to milliseconds

STAND_FOOT_POSITIONS = (
    (120.0, -100.0, 80.0, 1.0),
    (120.0, -100.0, -80.0, 1.0),
    (-20.0, -100.0, 80.0, 1.0),
    (-20.0, -100.0, -80.0, 1.0),
)
STAND_BODY_POS = (50.0, 80.0, 0.0)
STAND_BODY_ROT = (0.0, 0.0, 0.0)

ROBOT_L1 = 50   # Coxa link length in mm
ROBOT_L2 = 20   # Femur offset length in mm
ROBOT_L3 = 100  # Femur link length in mm
ROBOT_L4 = 100  # Tibia link length in mm
ROBOT_L = 140   # Body length (front-to-back leg spacing) in mm
ROBOT_W = 75    # Body width (left-to-right leg spacing) in mm

ROBOT_LEG_FRONT = 0
ROBOT_LEG_BACK = 2
ROBOT_LEG_LEFT = 0
ROBOT_LEG_RIGHT = 1

ROBOT_BODY_HEIGHT = -100

KB_KEY_VALUES = {'w': 0, 'a': 0, 's': 0, 'd': 0, 'q': 0, 'e': 0, 'move': False}
KB_CONTROL_OFFSET = {'IDstepLength': 0.0, 'IDstepWidth': 0.0, 'IDstepAlpha': 0.0, 'StartStepping': False}
KB_X_STEP_DIVISOR = 12.0
KB_Y_STEP = 5.0
KB_YAW_STEP = 3.0

MATH_PI_DIVISOR = 180  # Divisor for degree-to-radian conversion (pi / 180)

DATASET_ROOT_PATH = _env_path("WILDFIRE_DATASET_ROOT", "/workspace/wildfire-dataset")

DATASET_OUTPUT_PATH = _env_path(
    "WILDFIRE_DATASET_OUTPUT",
    os.path.join(DATASET_ROOT_PATH, "unified_dataset"),
)

DFIRE_CLEAN_YOLO_PATH = _env_path(
    "DFIRE_CLEAN_YOLO_PATH",
    "/workspace/wildfire-extra-datasets/DFire/clean_yolo",
)

NASA_AMS_CLEAN_YOLO_PATH = _env_path(
    "NASA_AMS_CLEAN_YOLO_PATH",
    "/workspace/wildfire-extra-datasets/NASA AMS/clean_yolo_patches",
)

KB_TEST_SLEEP_TIME = 1

ULTRASONIC_DISTANCE_MULTIPLIER = 17150  # Speed-of-sound constant for HC-SR04 pulse-to-cm conversion (34300 cm/s / 2)
DIRECTION_ANGLE_MULTIPLIER = 90  # Degrees per cardinal direction step
DEFAULT_DIRECTION_VALUE = 0.0
SERVO_TEST_ENDPOINT_VALUES = [[100, -100, 87.5, 1], [100, -100, -87.5, 1], [-100, -100, 87.5, 1], [-100, -100, -87.5, 1]]

PATROL_ZONE = []
PATROL_ZONE_MIN_POINTS = 3

EVIDENCE_DIR = _env_path("WILDFIRE_EVIDENCE_DIR", "evidence/fire_events")

GPS_READ_MAX_ATTEMPTS = 10

SENSOR_READ_TIMEOUT = 5.0  # Seconds to wait for a sensor read before timing out
LIDAR_READ_TIMEOUT = 10.0

SERVO_MAX_ANGLE = 180
SERVO_MIN_ANGLE = 0
SERVO_ANGLE_ADJUSTMENT = 1

DATASET_TRAIN_RATIO = 0.8
DATASET_VAL_RATIO = 0.1
DATASET_RANDOM_SEED = 42

AIHUB_DATASET_SUBPATH = "regional-safety-disaster-wildfire/01-1.official-open-data"
WANDB_PROJECT = os.environ.get("WANDB_PROJECT", "wildfire-detection")
WANDB_ENTITY = os.environ.get("WANDB_ENTITY") or None
TRAIN_MODEL_PATH = os.environ.get("WILDFIRE_TRAIN_MODEL", "yolov10s.pt")
TRAIN_DATA_YAML = _env_path(
    "WILDFIRE_TRAIN_DATA_YAML",
    os.path.join(DATASET_OUTPUT_PATH, "data.yaml"),
)
TRAIN_PROJECT_PATH = _env_path("WILDFIRE_TRAIN_PROJECT_PATH", "/workspace/runs")
TRAIN_OUTPUT_DIR = _env_path("WILDFIRE_TRAIN_OUTPUT_DIR", TRAIN_PROJECT_PATH)
TRAIN_EPOCHS = _env_int("WILDFIRE_TRAIN_EPOCHS", 200)
TRAIN_BATCH_SIZE = _env_int_or_auto("WILDFIRE_TRAIN_BATCH_SIZE", 32)
TRAIN_IMAGE_SIZE = _env_int("WILDFIRE_TRAIN_IMAGE_SIZE", 1280)
TRAIN_SAVE_PERIOD = _env_int("WILDFIRE_TRAIN_SAVE_PERIOD", 10)
TRAIN_PATIENCE = _env_int("WILDFIRE_TRAIN_PATIENCE", 30)
TRAIN_DEVICE = os.environ.get("WILDFIRE_TRAIN_DEVICE", "cuda")
TRAIN_NAME = os.environ.get("WILDFIRE_TRAIN_NAME", "wildfire_v1")
TRAIN_RUN_NAME = os.environ.get("WILDFIRE_TRAIN_RUN_NAME", TRAIN_NAME)
TRAIN_WORKERS = _env_int("WILDFIRE_TRAIN_WORKERS", 4)
TRAIN_RESUME = os.environ.get("WILDFIRE_TRAIN_RESUME", "").strip()
TRAIN_EXIST_OK = _env_bool("WILDFIRE_TRAIN_EXIST_OK", False)
TRAIN_AUGMENT = _env_bool("WILDFIRE_TRAIN_AUGMENT", True)
TRAIN_MOSAIC = _env_float("WILDFIRE_TRAIN_MOSAIC", 1.0)
TRAIN_HSV_H = _env_float("WILDFIRE_TRAIN_HSV_H", 0.02)
TRAIN_HSV_S = _env_float("WILDFIRE_TRAIN_HSV_S", 0.8)
TRAIN_HSV_V = _env_float("WILDFIRE_TRAIN_HSV_V", 0.4)
TRAIN_FLIPUD = _env_float("WILDFIRE_TRAIN_FLIPUD", 0.5)
TRAIN_FLIPLR = _env_float("WILDFIRE_TRAIN_FLIPLR", 0.5)

SPRING_API_BASE_URL = os.environ.get("SPRING_API_BASE_URL", "http://localhost:8080")
DEVICE_SERIAL_NUMBER = os.environ.get("DEVICE_SERIAL_NUMBER", "")
DEVICE_KEY = os.environ.get("DEVICE_KEY", "")
DEVICE_TELEMETRY_INTERVAL_SECONDS = _env_float("DEVICE_TELEMETRY_INTERVAL_SECONDS", 5.0)
FIRE_DETECTION_INTERVAL_SECONDS = _env_float("FIRE_DETECTION_INTERVAL_SECONDS", 1.0)
LOCAL_DASHBOARD_ENABLED = _env_bool("LOCAL_DASHBOARD_ENABLED", False)
SPRING_TELEMETRY_ENABLED = _env_bool("SPRING_TELEMETRY_ENABLED", False)

KINEMATICS_L1_DEFAULT = 50
KINEMATICS_L2_DEFAULT = 20
KINEMATICS_L3_DEFAULT = 100
KINEMATICS_L4_DEFAULT = 100
KINEMATICS_L_DEFAULT = 140
KINEMATICS_W_DEFAULT = 75
KINEMATICS_HEIGHT_DEFAULT = -100
KINEMATICS_BODY_POS_DEFAULT = (0, 100, 0)
KINEMATICS_BODY_ROT_DEFAULT = (0, 0, 0)
