DongjuLee0528/wildfire-spot/(commit log)

2026-05-25 feat: update servo_controller with PCA9685 #3 and config integration
2026-05-25 feat: add sensor_manager for MQ-2, SHT31, KY-026, HC-SR04
2026-05-25 feat: add pan_tilt_controller with 360/180 servo support
2026-05-25 feat: add gps_manager for NEO-6M UART parsing
2026-05-25 refactor: fix encapsulation, add exception handling, sync config and update README
    [sensor_manager.py, servo_controller.py]
2026-06-03 feat: add lidar_manager for UNITREE L2 UART and VFH+ obstacle avoidance
    [lidar_manager.py]
2026-06-06 refactor: add exception handling to kinematicMotion.py
2026-06-06 feat: add fire_detection module with sensor and camera integration
2026-06-10 docs: add comprehensive comments to all Python files, fix motro_num typo
    [config.py]
2026-06-13 feat: add STL files for hardware components
    [battery_cover.battery_cover.stl]
2026-06-16 refactor: rewrite GPL-3.0 based files and code cleanup
    - Rewrite kinematicMotion.py, servo_controller.py, kinematics.py (GPL-3.0 → custom license)
    - Add GPS patrol zone calibration mode in main.py
    - Fix bare except, hardcoding, resource management issues
    - Update config.py with new constants
    - Remove duplicate files
    [sensor_manager.py, servo_controller.py]
2026-06-16 fix: critical bug fixes and code improvements for fire detection and patrol zone
    - fix: fire_detection.py - ky026_flame → flame key fix
    - fix: fire_detection.py - remove duplicate sensor read in get_fire_location()
    - fix: fire_detection.py - add location length validation
    - fix: main.py - add coordinates type/length validation
    - fix: main.py - PATROL_ZONE serialization to JSON format
    - fix: main.py - improve PATROL_ZONE regex pattern matching
    - refactor: main.py - add cleanup() method to PatrolZoneCalibrator
    - refactor: utils/config.py - WANDB_ENTITY to environment variable
    [config.py, main.py]
2026-06-16 fix: hardware module improvements and bug fixes
    - fix: sensor_manager.py - separate _ads_available, _sht31_available flags
    - fix: sensor_manager.py - add hasattr check for sensor attributes
    - fix: sensor_manager.py - add try-except for GPIO.input()
    - fix: servo_controller.py - add array size validation
    - fix: servo_controller.py - add try-except in shutdown_servos()
    - fix: lidar_manager.py - add angle overflow check (% 360)
    - fix: lidar_manager.py - add try-except in close()
    - fix: gps_manager.py - optimize sleep position
    - fix: gps_manager.py - add try-except in close()
    - fix: pan_tilt_controller.py - rename speed → pan_angle parameter
    [gps_manager.py, lidar_manager.py, pan_tilt_controller.py, sensor_manager.py, servo_controller.py]
2026-06-16 fix: kinematics and motion control bug fixes
    - fix: kinematics.py - add domain error handling for sqrt and acos
    - fix: kinematics.py - add ZeroDivisionError check for L3, L4
    - fix: kinematics.py - clamp D value to [-1, 1] range
    - fix: kinematicMotion.py - add ZeroDivisionError check for total_period
    - fix: multiprocess_kb.py - add Lock for Queue synchronization
    - fix: multiprocess_kb.py - add _running flag and stop() method
    [kinematicMotion.py]
2026-06-17 feat: add WildfireLogger class
    - feat: utils/logger.py - file + console dual output
    - feat: utils/logger.py - log_fire_detected, log_sensor_values, log_system_state, log_gps_location, log_error methods
    - fix: utils/logger.py - add OSError handling for makedirs and FileHandler
    - fix: utils/logger.py - add close() method for handler cleanup
    - feat: utils/config.py - add LOG_DIR constant
    [logger.py]
2026-06-17 fix: reduce TRAIN_WORKERS from 16 to 4 to prevent OOM crash
    - fix: utils/config.py - TRAIN_WORKERS = 16 → 4
    - fix: training/train.py - use TRAIN_WORKERS from config
    [config.py]
2026-06-17 feat: integrate WildfireLogger into SensorManager
    - feat: hardware/sensor_manager.py - add WildfireLogger integration
    - fix: hardware/sensor_manager.py - add error logging for GPIO setup failures
    - fix: hardware/sensor_manager.py - add try-except for read_hcsr04()
    - fix: hardware/sensor_manager.py - add I2C resource cleanup in cleanup()
    [sensor_manager.py]
2026-06-17 feat: integrate WildfireLogger into GPSManager
    - feat: hardware/gps_manager.py - add WildfireLogger integration
    - fix: hardware/gps_manager.py - remove duplicate log_gps_location() calls
    - fix: hardware/gps_manager.py - add error logging in close()feat: integrate WildfireLogger into GPSManager
    - feat: hardware/gps_manager.py - add WildfireLogger integration
    - fix: hardware/gps_manager.py - remove duplicate log_gps_location() calls
    - fix: hardware/gps_manager.py - add error logging in close()
    [gps_manager.py]
2026-06-17 feat: integrate WildfireLogger into main and fix error handling
    - feat: main.py - add WildfireLogger integration
    - feat: main.py - add system state logging
    - fix: main.py - add error logging for KeyboardInput failures
    - fix: main.py - add try-except for get_key() method
    - fix: main.py - add error logging for GPS failures
    - fix: main.py - add PATROL_ZONE pattern not found handling
    - fix: main.py - add WildfireLogger initialization try-except
    - fix: main.py - add break on main loop exception
    feat: integrate WildfireLogger into main and fix error handling
    - feat: main.py - add WildfireLogger integration
    - feat: main.py - add system state logging
    - fix: main.py - add error logging for KeyboardI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
    [main.py]
2026-06-17 feat: flexible patrol zone calibration with SPACE+F keys
    - feat: main.py - change calibration from fixed 4 points to flexible points
    - feat: main.py - add F key to complete calibration
    - feat: main.py - SPACE key adds GPS coordinate one by one
    [main.py]
2026-06-17 fix: update config constants
    - feat: utils/config.py - add PATROL_ZONE_MIN_POINTS = 3
    - fix: utils/config.py - remove PATROL_ZONE_MAX_POINTS
    - fix: utils/config.py - LOG_DIR now uses BASE_DIR instead of hardcoded path
    [config.py]
2026-06-17 feat: add StateMachine with RobotState enum
    - feat: utils/state_machine.py - add RobotState enum (CALIBRATING, IDLE, PATROLLING, DETECTING, FIRE_DETECTED, REPORTING, RETURNING, ERROR)
    - feat: utils/state_machine.py - add StateMachine class with state transition validation
    - feat: utils/state_machine.py - integrate WildfireLogger for state change logging
    - fix: utils/state_machine.py - add try-except for WildfireLogger initialization
    [state_machine.py]
2026-06-18 fix: make dataset preprocessing reproducible
    [config.py]
2026-06-19 fix(preprocess): include negative samples with empty labels
2026-06-21 fix(dataset): enforce YOLO-compatible image formats
    [config.py]
2026-06-21 fix(preprocess): force RGB JPG materialization for unified dataset images
    [sensor_manager.py]
2026-06-21 fix(training): harden dataset publishing and input validation
    [config.py]
2026-06-23 fix(utils): improve configuration and logging resilience
    [config.py]
2026-06-23 fix(hardware): improve runtime safety and hardware compatibility
    [lidar_manager.py]
2026-06-23 fix(kinematics): improve runtime safety and numerical stability
2026-06-25 feat(sensor): migrate from SHT31 to DHT11
2026-06-26 feat(adapter): prepare status gps sensor integration layer
2026-06-26 fix(sensor): support single ADS1115 configuration
    [config.py]
2026-06-26 refactor(lidar): migrate unitree l2 transport to ethernet udp
2026-06-27 fix(robot): add typed log entries to RobotLogsData
    [robot_api_types.py]
2026-06-28 feat(gateway): implement read-only spring python integration
2026-06-29 feat(lidar): implement scan processing, obstacle detection and path evaluation
2026-07-03 feat(vision): add camera-based fire detection pipeline and update gitignore for model artifacts
2026-07-03 feat(ai): add wildfire baseline model and reproducibility artifacts
    [results.csv]
2026-07-03 feat(detection): add staged fire verification policy
2026-07-03 feat(control): add auto manual mode switching
2026-07-03 test(api): strengthen fire event payload contract coverage
    [robot_api.py]
2026-07-04 fix(robot): return default sensor values in fallback response
    [robot_api.py]
2026-07-04 feat(server): add mission zone spring integration
2026-07-05 feat(camera): add manual pan tilt control
2026-07-06 feat(camera): add python camera control api
2026-07-06 feat(server): add camera control api
2026-07-06 feat(web): add camera control section
2026-07-07 fix(web): compact camera control panel
2026-07-07 fix(web): enlarge camera stream layout
2026-07-07 feat(web): connect camera controls to api
2026-07-07 fix(robot): wire camera control manager into robot api
    [main.py, robot_api.py]
2026-07-07 feat(robot): add camera mjpeg stream endpoint
2026-07-07 feat(server): proxy camera mjpeg stream
2026-07-07 feat(web): bind camera stream to dashboard
2026-07-07 feat(web): bind sensor data to dashboard
2026-07-07 feat(device): implement device registration
2026-07-08 fix(device): use persisted device status for online state
2026-07-09 fix(robot): correct ADS1115 channel initialization
    [sensor_manager.py]
2026-07-09 fix(robot): use Pin API for ADS1115 channel
    [sensor_manager.py]
2026-07-09 fix(robot): validate ADS1115 Pin API correctly
    [sensor_manager.py]
2026-07-09 fix(robot): connect manual control to keyboard movement queue
    [main.py]
2026-07-10 fix(robot): standardize PCA9685 I2C and four-leg mapping
    [main.py]
2026-07-10 fix(robot): eliminate queue contention between monitor and gait loop
    [main.py]
2026-07-10 chore(debug): add gait and servo output diagnostics
2026-07-12 fix(web): stop robot movement when control button is released
2026-07-13 fix(robot): apply stand pose during startup and stop
    [config.py]
2026-07-13 fix(gait): align runtime body pose with reference implementation
    [config.py]
2026-07-13 fix(gait): reduce rear foot offset to prevent femur overextension
    [config.py]
2026-07-14 Add rear leg gait debug logging
2026-07-14 Reduce gait step height to mitigate leg overextension
2026-07-14 Fix FORWARD and STOP queue race in gait loop
    [main.py]
2026-07-14 feat(runtime): connect CameraVision to FireDetector
2026-07-15 fix(runtime): share CameraVision across detection and API
    [main.py]
2026-07-15 fix(vision): synchronize camera frame access
2026-07-15 chore(debug): add CameraVision detection debug logs
2026-07-15 fix(stream): render overlay on live camera frames
2026-07-15 fix(runtime): gracefully stop fire detection thread
    [main.py]
2026-07-15 fix(runtime): keep fire evaluation active without camera
    [main.py]
2026-07-15 fix(sensor): handle missing DHT11 values safely
    [logger.py]
2026-07-20 fix: remove stale MQ-2 paths and correct fire state transitions
    [logger.py]
2026-07-24 feat(lidar): implement _parse_udp_packet() for Unitree L2 UDP protocol
    - Parse binary packet with magic 0x55AA050A, packet_type 102
    - Extract angle from geometry header (h_angle_start + i * h_angle_step)
    - Return {angle_deg: distance_mm} dict for obstacle detection
2026-07-24 fix(lidar): remove UDP header offset, parse raw payload directly
    - Remove 8-byte UDP header skip (_UDP_HEADER_SIZE)
    - Adjust offsets: geometry 96→88, point_num 128→120, ranges 132→124
    - Fix _PAYLOAD_MIN_SIZE to match actual packet size (1044 bytes)
    - Verified with Unitree L2 real packet (magic at offset 0)
    [lidar_manager.py]
2026-07-24 fix(lidar): correct magic byte order to 0x0A05AA55 (little-endian)
    - Actual received magic is 0x0A05AA55 when read as little-endian uint32
    - Previous value 0x55AA050A caused all 1044-byte packets to be dropped
    [lidar_manager.py]
2026-07-24 fix(lidar): correct geometry/point offsets and convert h_step from radians
    - h_angle_start offset: 88 → 112
    - h_step offset: 92 → 120 (radians, convert to degrees)
    - point_num offset: 120 → 128
    - ranges offset: 124 → 132
    [lidar_manager.py]
2026-08-30 fix: reject invalid inverse kinematics commands
    [test_ik_failure_handling.py]
2026-08-30 fix: fail closed on invalid quadruped IK results
    [gait_diagnostics.py]
2026-09-01 fix: restore fail-closed IK error handling
    [main.py]
2026-11-02 Add sensor-origin views and fading point-cloud trails
2026-11-02 Add shared camera capture and isolated person detection
